lucashadfield/timecube/README.md

# timecube
> e-ink pomodoro timer

[Time Cube.webm](https://user-images.githubusercontent.com/12473153/235540202-a3ebf8da-60be-4fac-9890-19129da23939.webm)
