lucashadfield/timecube/model/outer.FCStd

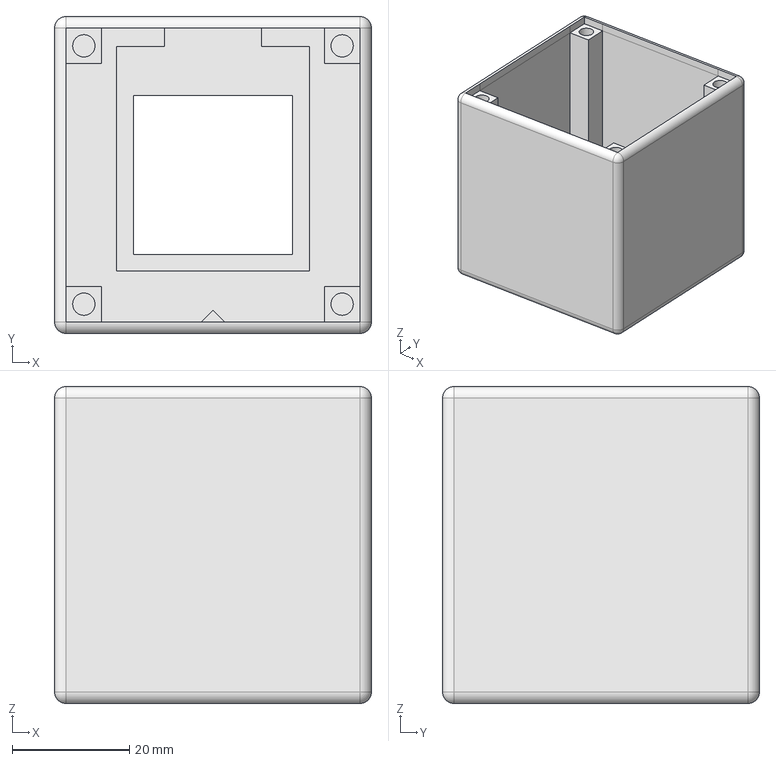
[picture p1: CAD file, 2022-09-03]
model/outer.FCStd
54.0 x 54.0 x 54.0 mm
