lucashadfield/timecube/model/back_plate.FCStd

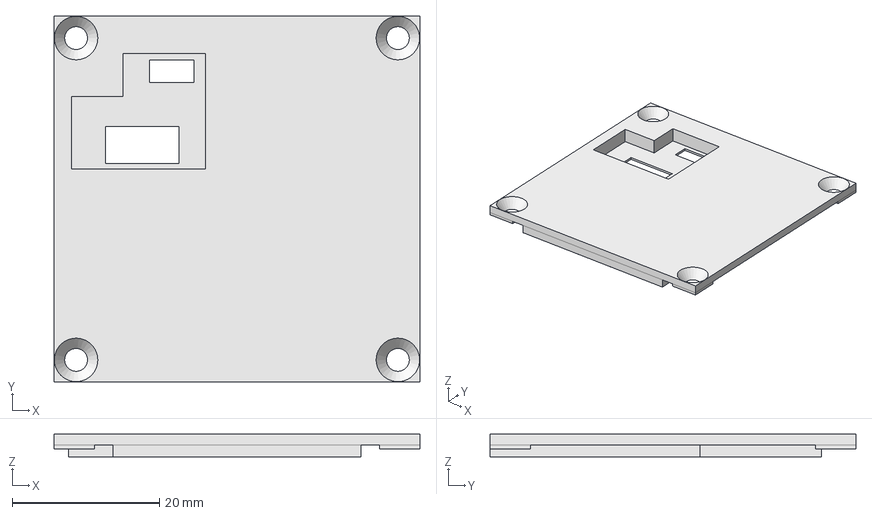
[picture p2: CAD file, 2022-09-03]
model/back_plate.FCStd
49.7 x 49.7 x 3.10 mm
