lucashadfield/timecube/model/inner.FCStd

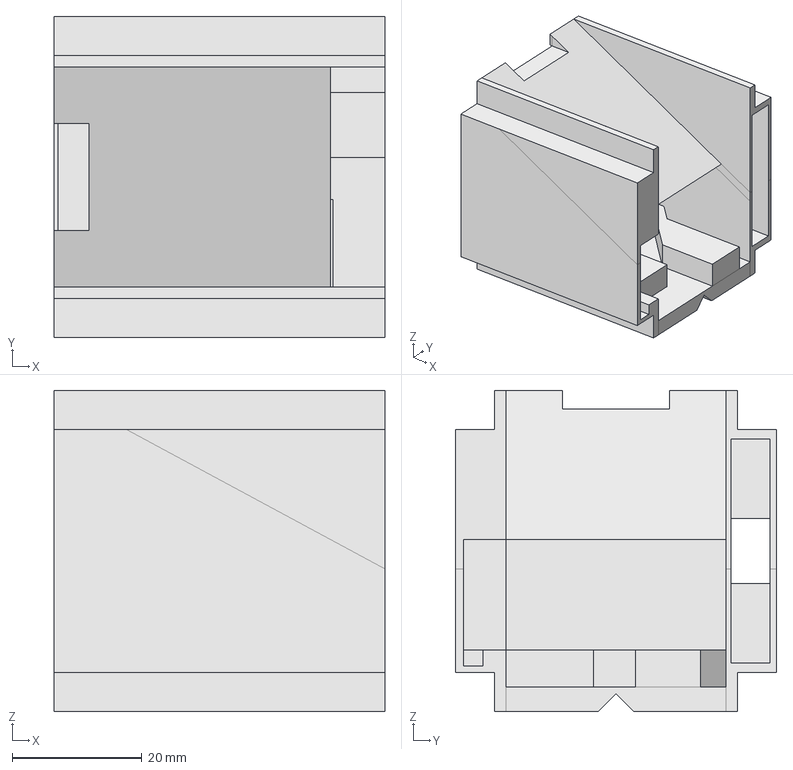
[picture p3: CAD file, 2022-08-29]
model/inner.FCStd
51.0 x 49.5 x 49.5 mm
