lucashadfield/timecube/(list of files, cad)

Other CAD files:
model/back_plate.stl
model/inner.stl
model/outer.stl
