lucashadfield/timecube/pcb/pcb.kicad_pcb

## KiCad design pcb/pcb.kicad_pcb (2022-08-29)

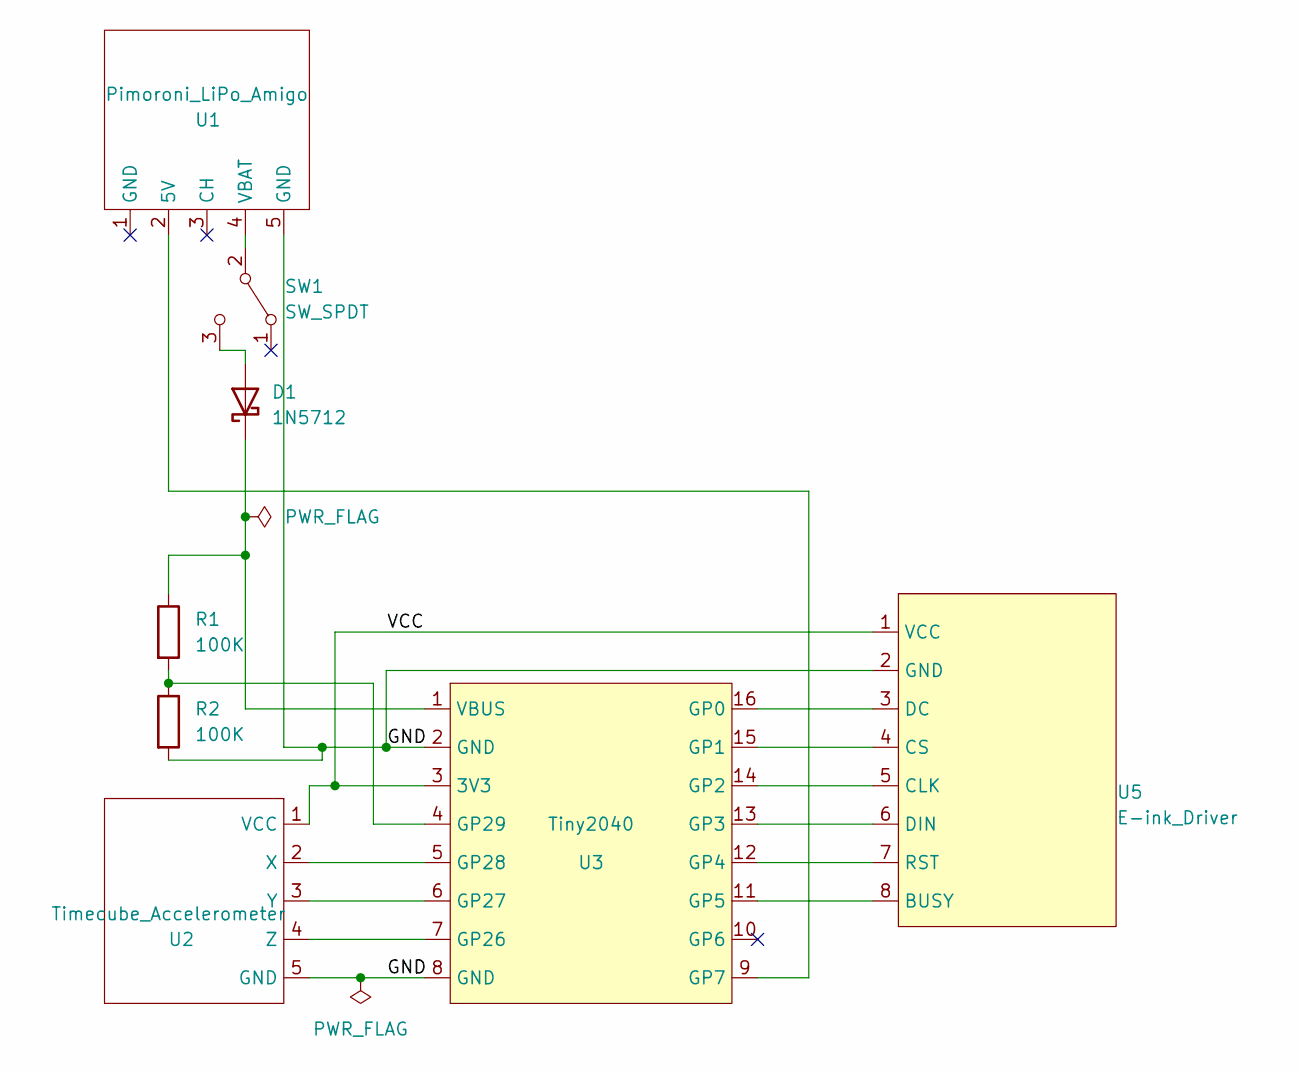
[picture p4: schematic pcb.kicad_sch]

Parts:
D1: 1N5712; D_DO-35_SOD27_P7.62mm_Horizontal
R1, R2: 100K; R_Axial_DIN0207_L6.3mm_D2.5mm_P10.16mm_Horizontal
SW1: SW_SPDT; Switch
U1: Pimoroni_LiPo_Amigo; LiPo Amigo
U2: Timecube_Accelerometer; ADXL335
U3: Tiny2040
U5: E-ink_Driver; Driver Data

Connections:
/GND: R2.2, U1.5 (GND), U2.5 (GND), U3.2 (GND), U3.8 (GND), U5.2 (GND)
/VCC: U2.1 (VCC), U3.3 (3V3), U5.1 (VCC)
unnamed: D1.1 (K), R1.1, U3.1 (VBUS)
unnamed: R1.2, R2.1, U3.4 (GP29)
unnamed: D1.2 (A), SW1.3 (C)
unnamed: SW1.2 (B), U1.4 (VBAT)
unnamed: U2.2 (X), U3.5 (GP28)
unnamed: U2.3 (Y), U3.6 (GP27)
unnamed: U2.4 (Z), U3.7 (GP26)
unnamed: U1.2 (5V), U3.9 (GP7)
unnamed: U3.16 (GP0), U5.3 (DC)
unnamed: U3.15 (GP1), U5.4 (CS)
unnamed: U3.14 (GP2), U5.5 (CLK)
unnamed: U3.13 (GP3), U5.6 (DIN)
unnamed: U3.12 (GP4), U5.7 (RST)
unnamed: U3.11 (GP5), U5.8 (BUSY)

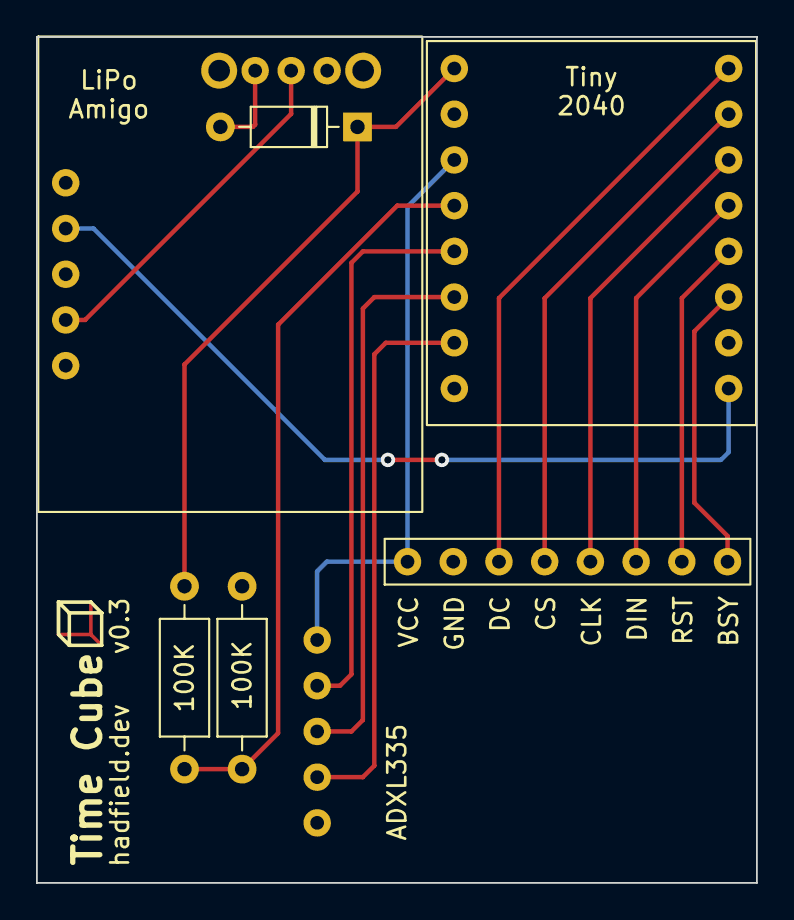
[picture p5: board pcb.kicad_pcb from above]

Board: 2 copper layers, 40.0 x 47.0 mm, 8 parts (0 on the bottom side), 16 nets.
