lucashadfield/timecube/(commit log)

2022-05-08 basic functionality running on hardware
    [inner2.FCStd, inner_v3.FCStd, inner_v3.stl, outer_v3.FCStd, outer_v3.stl]
2022-08-29 pcb 0.3, inner v4, flash_files update
    [inner_v4.FCStd, inner_v4.stl, inner_v4b.stl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]
